teohdg/measured-pedal/photos/breadboard.jpg

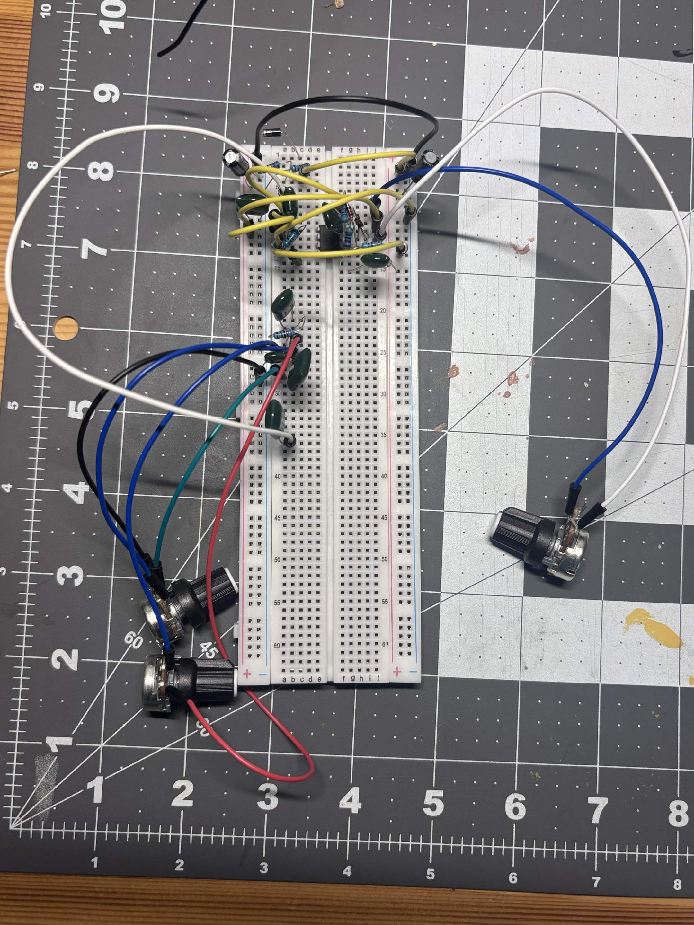
photos/breadboard.jpg
