teohdg/measured-pedal/simulation/circuit.png

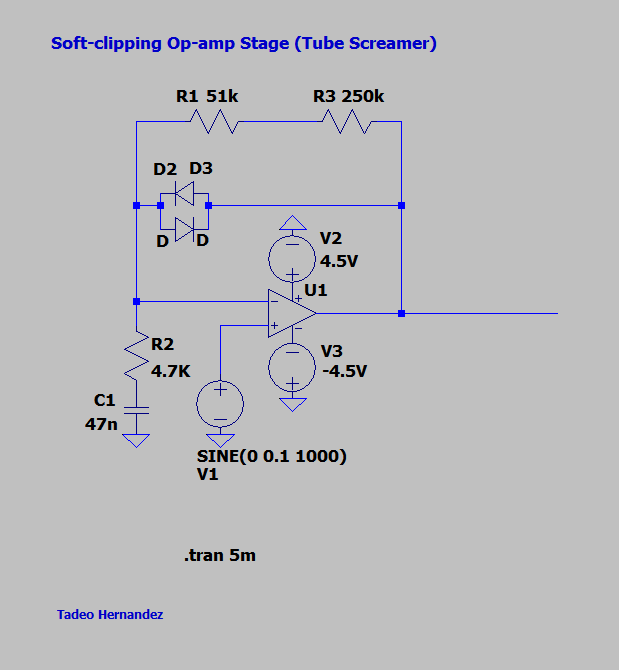
simulation/circuit.png
