teohdg/measured-pedal/simulation/firstgraph.png

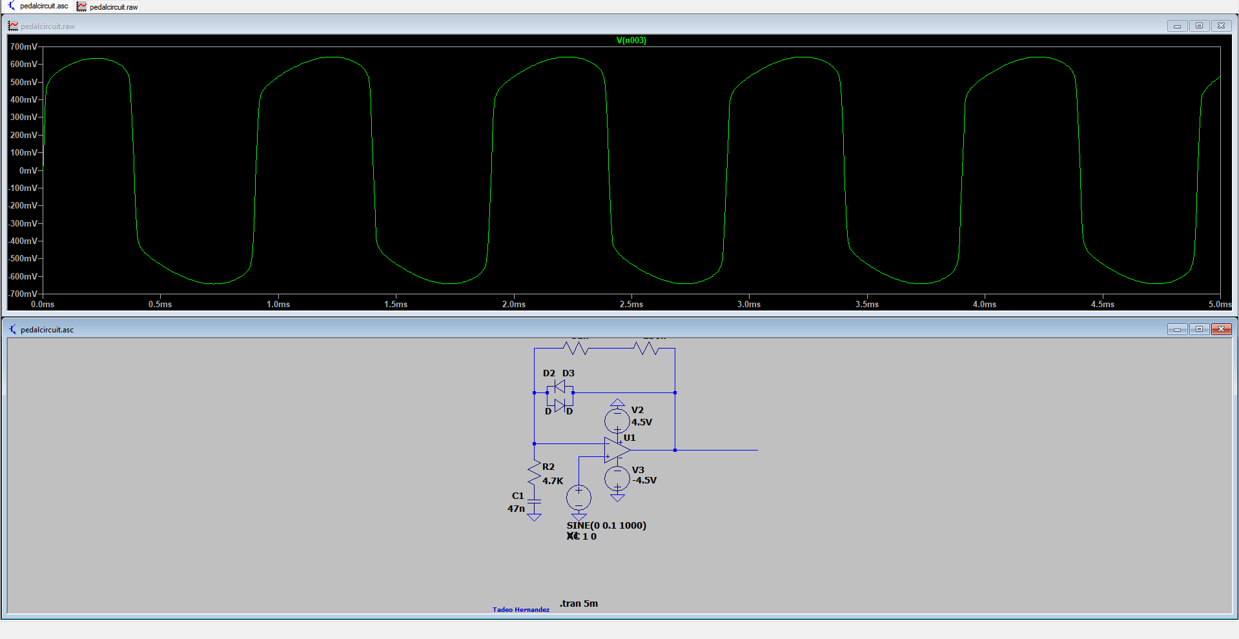
simulation/firstgraph.png
