teohdg/measured-pedal/simulation/gain_vs_drive.png

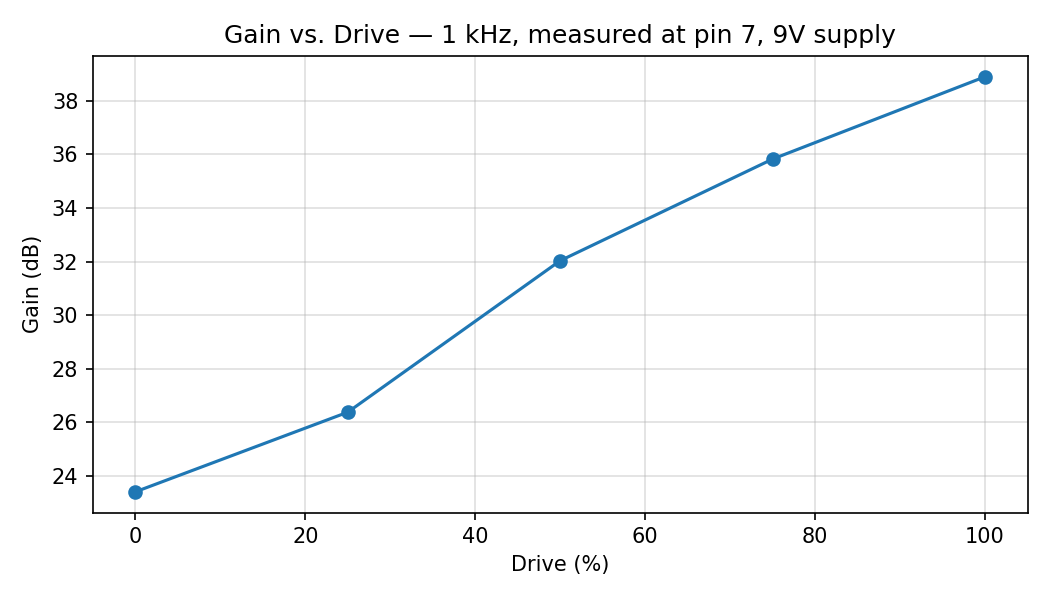
simulation/gain_vs_drive.png
