teohdg/measured-pedal/simulation/thd_vs_level.png

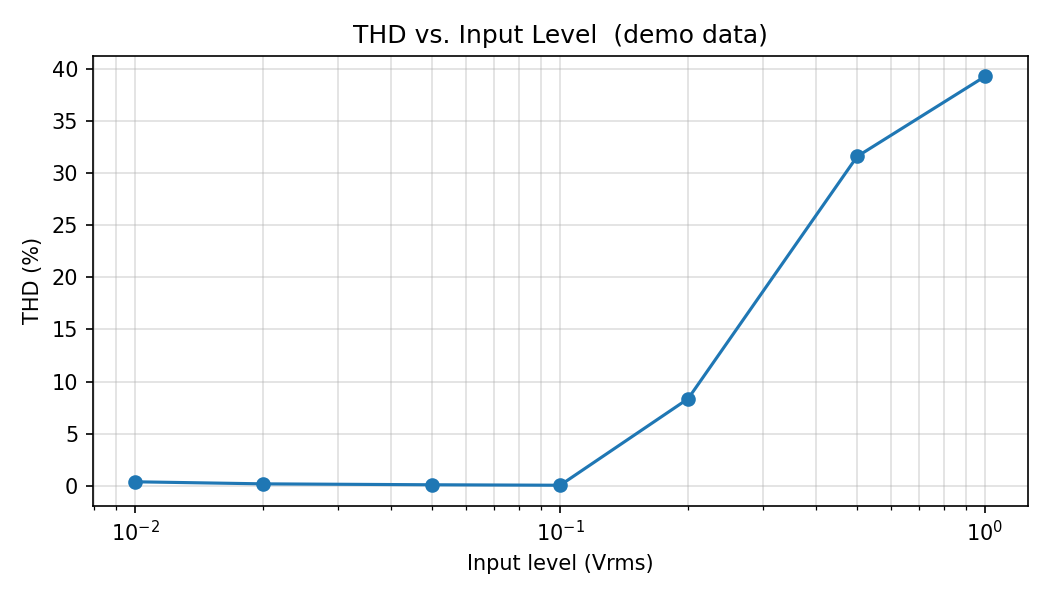
simulation/thd_vs_level.png
