teohdg/measured-pedal/simulation/pedalcircuit.asc

C1: cap; 47n
D2: diode
D3: diode
R1: res; 51k
R2: res; 4.7K
R3: res; 250k
U1: UniversalOpAmp1
V1: voltage; SINE(0 100m 1k); AC 1 0
V2: voltage; 4.5V
V3: voltage; -4.5V
Named nets: 0, out
Soft-clipping Op-amp Stage (Tube Screamer)
Tadeo Hernandez
.tran 50m
.four 1k V(out)
